chentadot/b-parasite/kicad/parasite.kicad_pcb

## KiCad design kicad/parasite.kicad_pcb (2021-05-27)

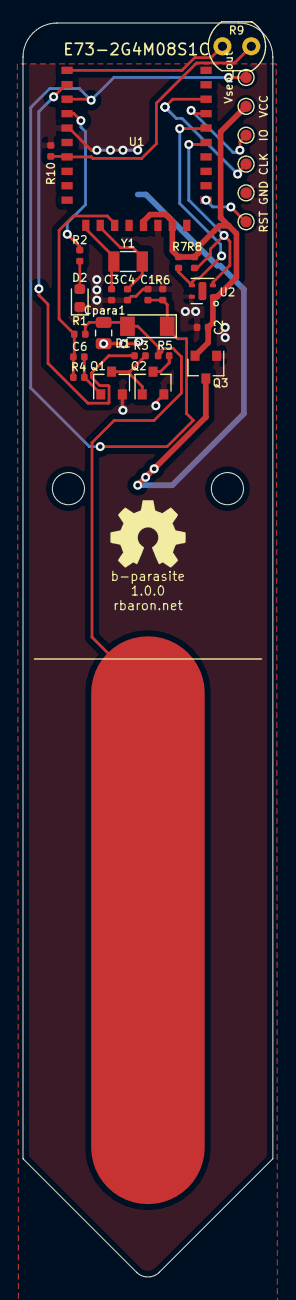
[picture p8: board parasite.kicad_pcb from above]

Board: 2 copper layers, 22.0 x 110.4 mm, 31 parts (1 on the bottom side), 21 nets.

Parts:
BT1: Battery_Cell; BatteryHolder_Keystone_3002_1x2032
C1: 1n; C_0402_1005Metric
C2: 100n; C_0402_1005Metric
C3, C4: 12p; C_0402_1005Metric
C6: 100p; C_0402_1005Metric
Cpara1: 5p; C_0805_2012Metric
D1: LL4148; D_MiniMELF
D2: LED; LED_0603_1608Metric
Q1, Q2: MMBT3904; SOT-23
Q3: AO3407; SOT-23
R1, R4, R7, R8, R10: 10k; R_0402_1005Metric
R2, R3, R5: 1k; R_0402_1005Metric
R6: 1M; R_0402_1005Metric
R9: R_PHOTO; R_LDR_4.9x4.2mm_P2.54mm_Vertical
TP1: IO; TestPoint_Pad_D1.0mm
TP2: CLK; TestPoint_Pad_D1.0mm
TP4: Vsen_out; TestPoint_Pad_D1.0mm
TP5: RST; TestPoint_Pad_D1.0mm
TP6: GND; TestPoint_Pad_D1.0mm
TP7: VCC; TestPoint_Pad_D1.0mm
U1: E73-2G4M08S1C-52840
U2: SHTC3; Sensirion_DFN-4-1EP_2x2mm_P1mm_EP0.7x1.6mm
Y1: 32.768kHz; Crystal_SMD_3215-2Pin_3.2x1.5mm

Connections:
+3V0: C2.1, Q3.2, R7.2, R8.1, TP7.1, U1.19, U1.23, U2.1
/Csen+: Cpara1.2, D1.2, R1.2, R5.1
/FAST_DISCH_EN: R3.1, U1.2
/LED: R2.1, U1.4
/PHOTO_OUT: R9.1, R10.2, U1.7
/PHOTO_V: R9.2, U1.1
/PWM: C6.2, R1.1, R4.2, U1.15
/SCL: R8.2, U1.33, U2.2
/SDA: R7.1, U1.35, U2.3
/SENS_OUT: C1.1, D1.1, R6.1, TP4.1, U1.3
GND: BT1.2, C1.2, C2.2, C3.2, C4.1, Cpara1.1, D2.1, Q1.2, Q2.2, Q3.1, R6.2, R10.1, TP6.1, U1.5, U1.21, U2.4
unnamed: BT1.1, Q3.3
unnamed: C3.1, U1.11, Y1.1
unnamed: C4.2, U1.13, Y1.2
unnamed: C6.1, Q1.1, R4.1
unnamed: D2.2, R2.2
unnamed: Q1.3, Q2.1, R3.2
unnamed: Q2.3, R5.2
unnamed: TP1.1, U1.37
unnamed: TP2.1, U1.39
unnamed: TP5.1, U1.26
