chentadot/b-parasite/(commit log)

2021-05-25 [ImgBot] Optimize images
    *Total -- 11,401.12kb -> 10,274.63kb (9.88%)
    /img/scope/8dbm-across-10ohm.png -- 50.51kb -> 17.62kb (65.11%)
    /img/scope/0dbm-no-led-across-10ohm.png -- 40.69kb -> 15.50kb (61.9%)
    /img/scope/0dbm-across-10ohm.png -- 40.41kb -> 15.45kb (61.77%)
    /img/case/screenshot.png -- 413.36kb -> 289.88kb (29.87%)
    /img/excalidraw/diagram.png -- 194.92kb -> 140.15kb (28.1%)
    /img/orig/img1.jpg -- 4,203.58kb -> 3,825.15kb (9%)
    /img/resized/img2.jpg -- 314.18kb -> 287.22kb (8.58%)
    /img/orig/img3.jpg -- 2,269.70kb -> 2,085.89kb (8.1%)
    /img/resized/img1.jpg -- 471.39kb -> 433.77kb (7.98%)
    /img/resized/img3.jpg -- 258.51kb -> 239.40kb (7.39%)
    /img/orig/img2.jpg -- 3,143.88kb -> 2,924.61k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
2021-05-25 Add Photoresistor
    [parasite-B_Cu.gbr, parasite-B_Mask.gbr, parasite-B_Paste.gbr, parasite-B_SilkS.gbr, parasite-Edge_Cuts.gbr, parasite-F_Cu.gbr, parasite-F_Mask.gbr, parasite-F_Paste.gbr]
2021-05-26 Supply V to photoresitor using nrf pin
    [parasite.csv, parasite.kicad_pcb, parasite.sch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]
2021-05-26 minor adjustments to silkscreen
    [parasite.kicad_pcb]
2021-05-26 Update GERBER
    [parasite-B_Cu.gbr, parasite-B_Mask.gbr, parasite-B_Paste.gbr, parasite-B_SilkS.gbr, parasite-Edge_Cuts.gbr, parasite-F_Cu.gbr, parasite-F_Mask.gbr, parasite-F_Paste.gbr]
2021-05-27 simplify voltage divider
    [parasite-B_Cu.gbr, parasite-B_Mask.gbr, parasite-B_Paste.gbr, parasite-B_SilkS.gbr, parasite-Edge_Cuts.gbr, parasite-F_Cu.gbr, parasite-F_Mask.gbr, parasite-F_Paste.gbr]
2021-07-05 First draft for Photoresistor
    the code now should setup and use the photoresistor and read it's value by the adc.
    the returned value is 0 just as a place holder until the correct values are measured.
    [adc.c, adc.h, main.c, prst_config.h]
